Edwindata/CANSAT/Esquematico de base terrena (1).pdf

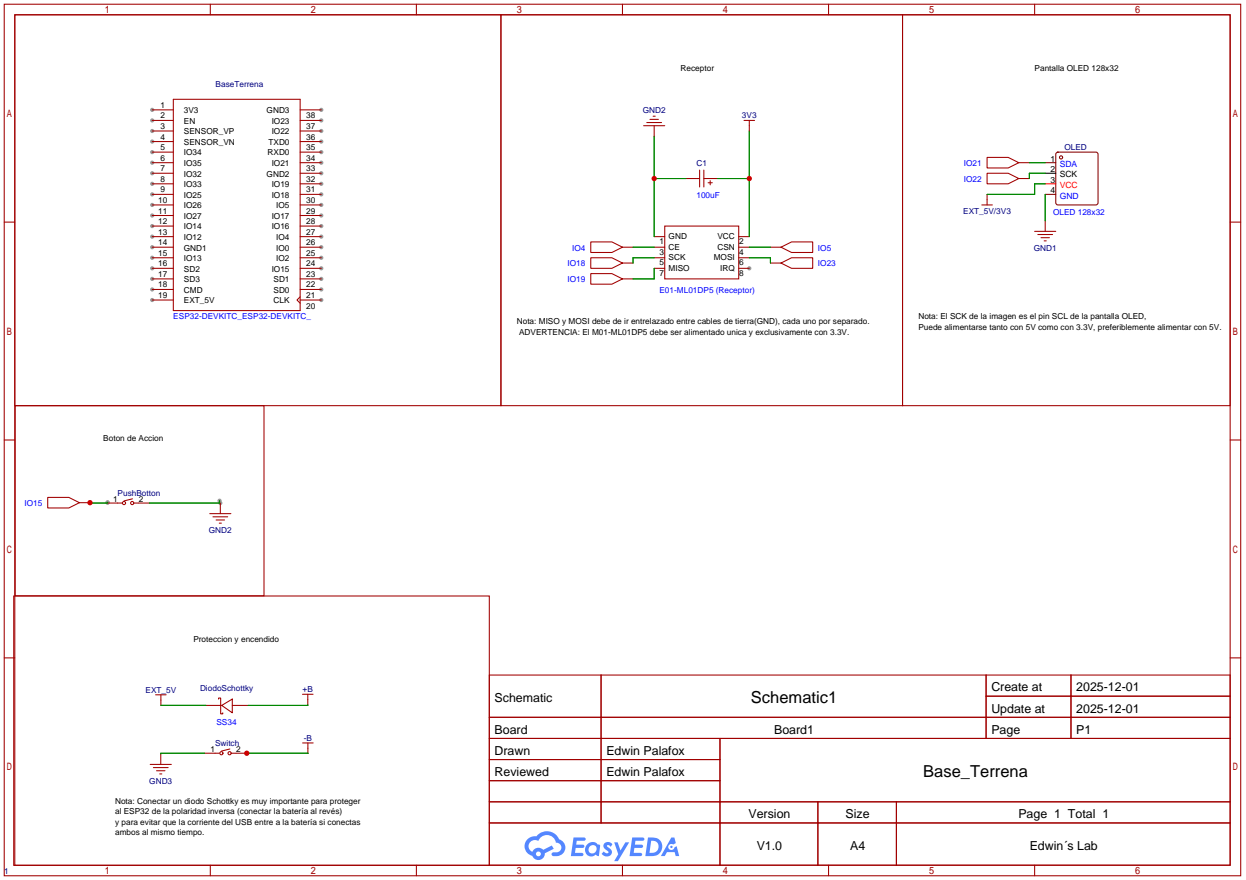
[picture p1: page 1]

Nota: El SCK de la imagen es el pin SCL de la pantalla OLED,
Puede alimentarse tanto con 5V como con 3.3V, preferiblemente alimentar con 5V.

Nota: MISO y MOSI debe de ir entrelazado entre cables de tierra(GND), cada uno por separado.
ADVERTENCIA: El M01-ML01DP5 debe ser alimentado unica y exclusivamente con 3.3V.

Schematic | Schematic1 | Create at | 2025-12-01

Update at | 2025-12-01

Board | Board1 | Page | P1
Drawn | Edwin Palafox | Base_Terrena
Reviewed | Edwin Palafox

Nota: Conectar un diodo Schottky es muy importante para proteger
al ESP32 de la polaridad inversa (conectar la batería al revés)
y para evitar que la corriente del USB entre a la batería si conectas
ambos al mismo tiempo.

Version | Size | Page 1 Total 1

V1.0 | A4 | Edwin´s Lab
